Poemtys/ssl-all/前挡板.SLDPRT

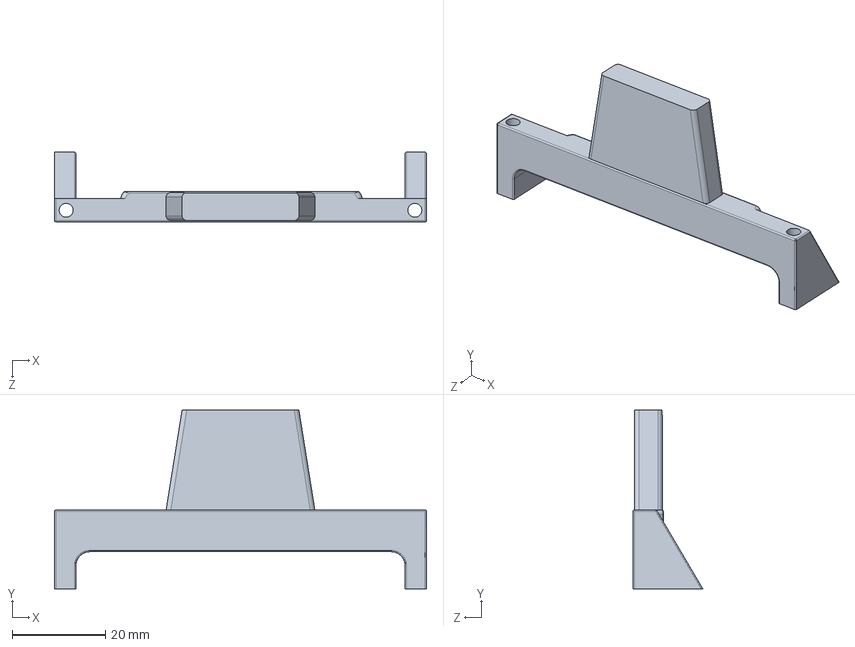
[picture p6: CAD file, 2024-06-06]
前挡板.SLDPRT
80.0 x 38.5 x 15.0 mm
