Poemtys/ssl-all/后挡板.SLDPRT

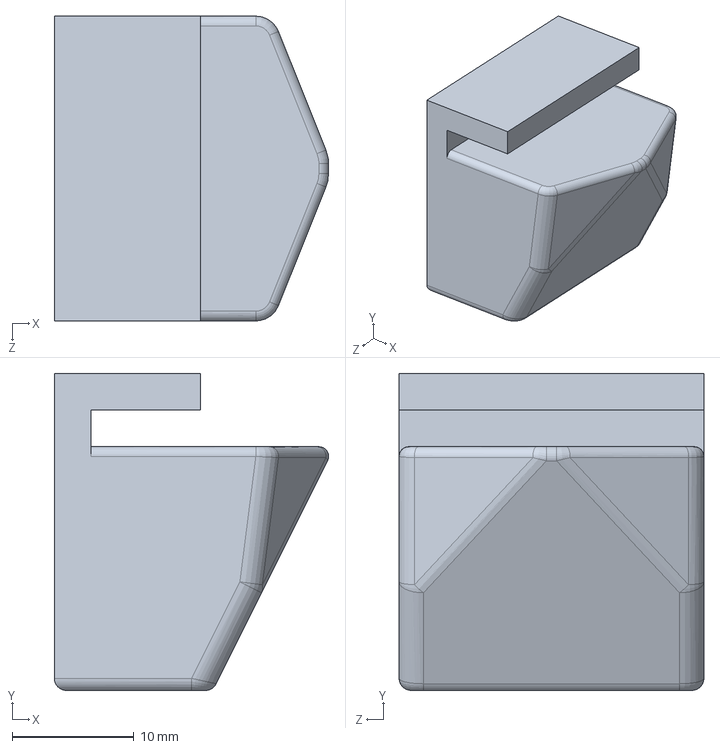
[picture p7: CAD file, 2024-06-06]
后挡板.SLDPRT
22.5 x 26.0 x 25.0 mm
