Poemtys/ssl-all/111.SLDPRT

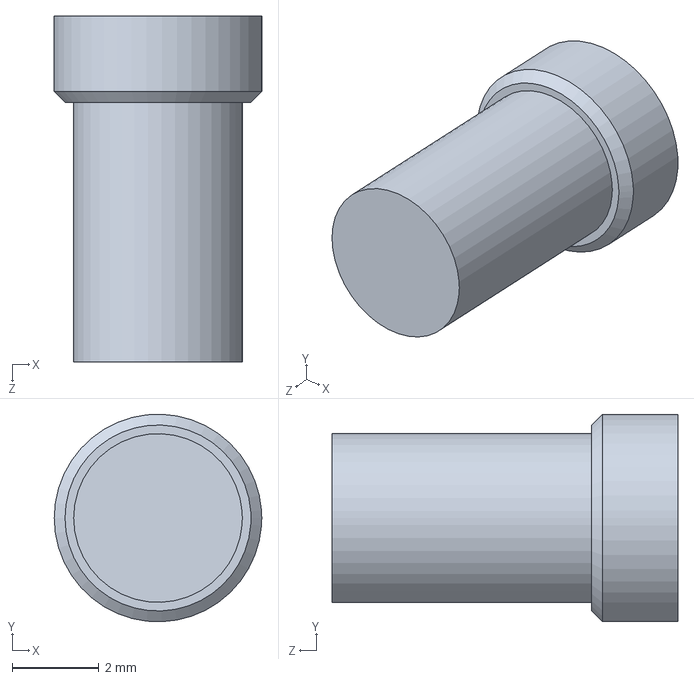
[picture p8: CAD file, 2024-06-06]
111.SLDPRT
4.80 x 4.80 x 8.00 mm
