Poemtys/ssl-all/m0.5motorgear.STEP

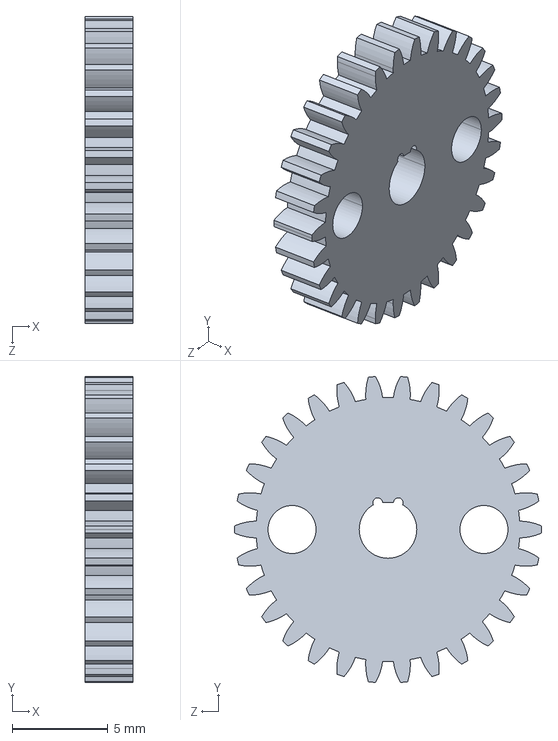
[picture p9: CAD file, 2024-06-06]
m0.5motorgear.STEP
2.50 x 15.9 x 16.0 mm
