Poemtys/ssl-all/零件1.SLDPRT

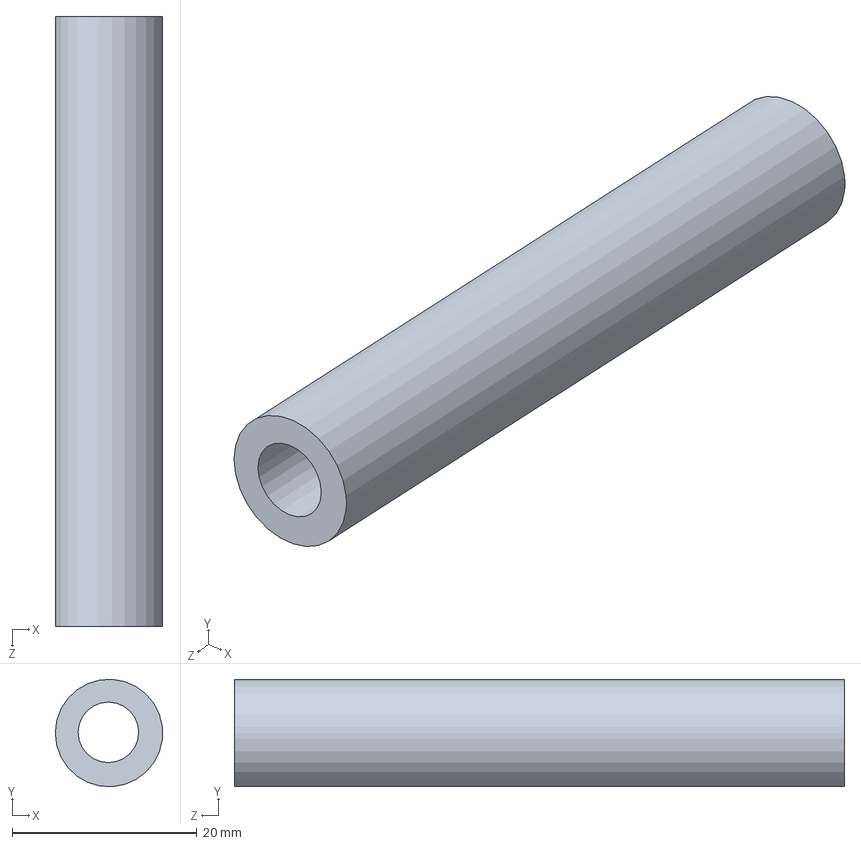
[picture p10: CAD file, 2024-06-06]
零件1.SLDPRT
11.6 x 11.6 x 66.0 mm
