Poemtys/ssl-all/电池盒.SLDPRT

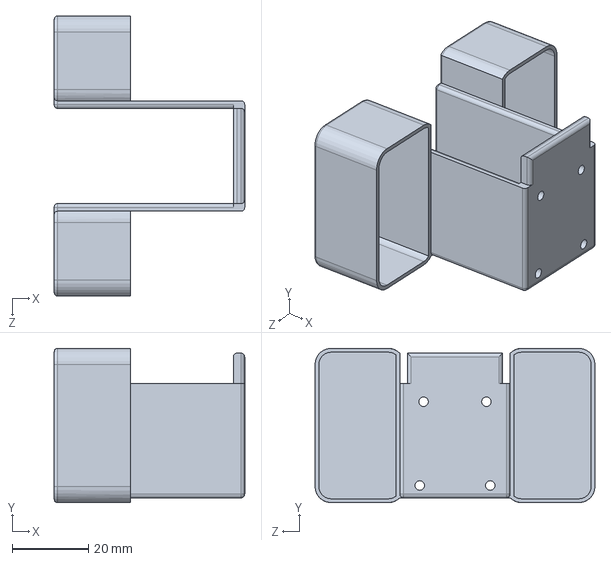
[picture p11: CAD file, 2024-06-06]
电池盒.SLDPRT
50.0 x 40.5 x 73.5 mm
