Poemtys/ssl-all/100832.SLDPRT

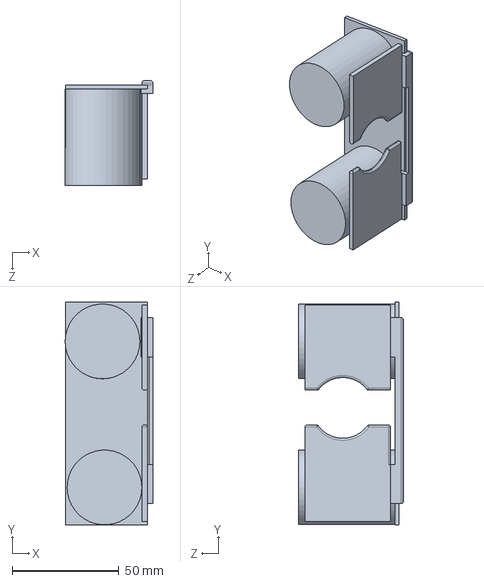
[picture p12: CAD file, 2024-06-06]
100832.SLDPRT
41.1 x 104.4 x 49.0 mm
