Poemtys/ssl-all/(list of files, cad)

Other CAD files:
零件4.SLDDRW
