Poemtys/ssl-all/SSLCtrlBrd_Ver1.3.pdf

PE7 | 38 PE8 | 39 PE9 | 40 PE10 | 41 PE11 | 42 PE12 | 43 PE13 | 44 PE14 | 45 PE15 | 46

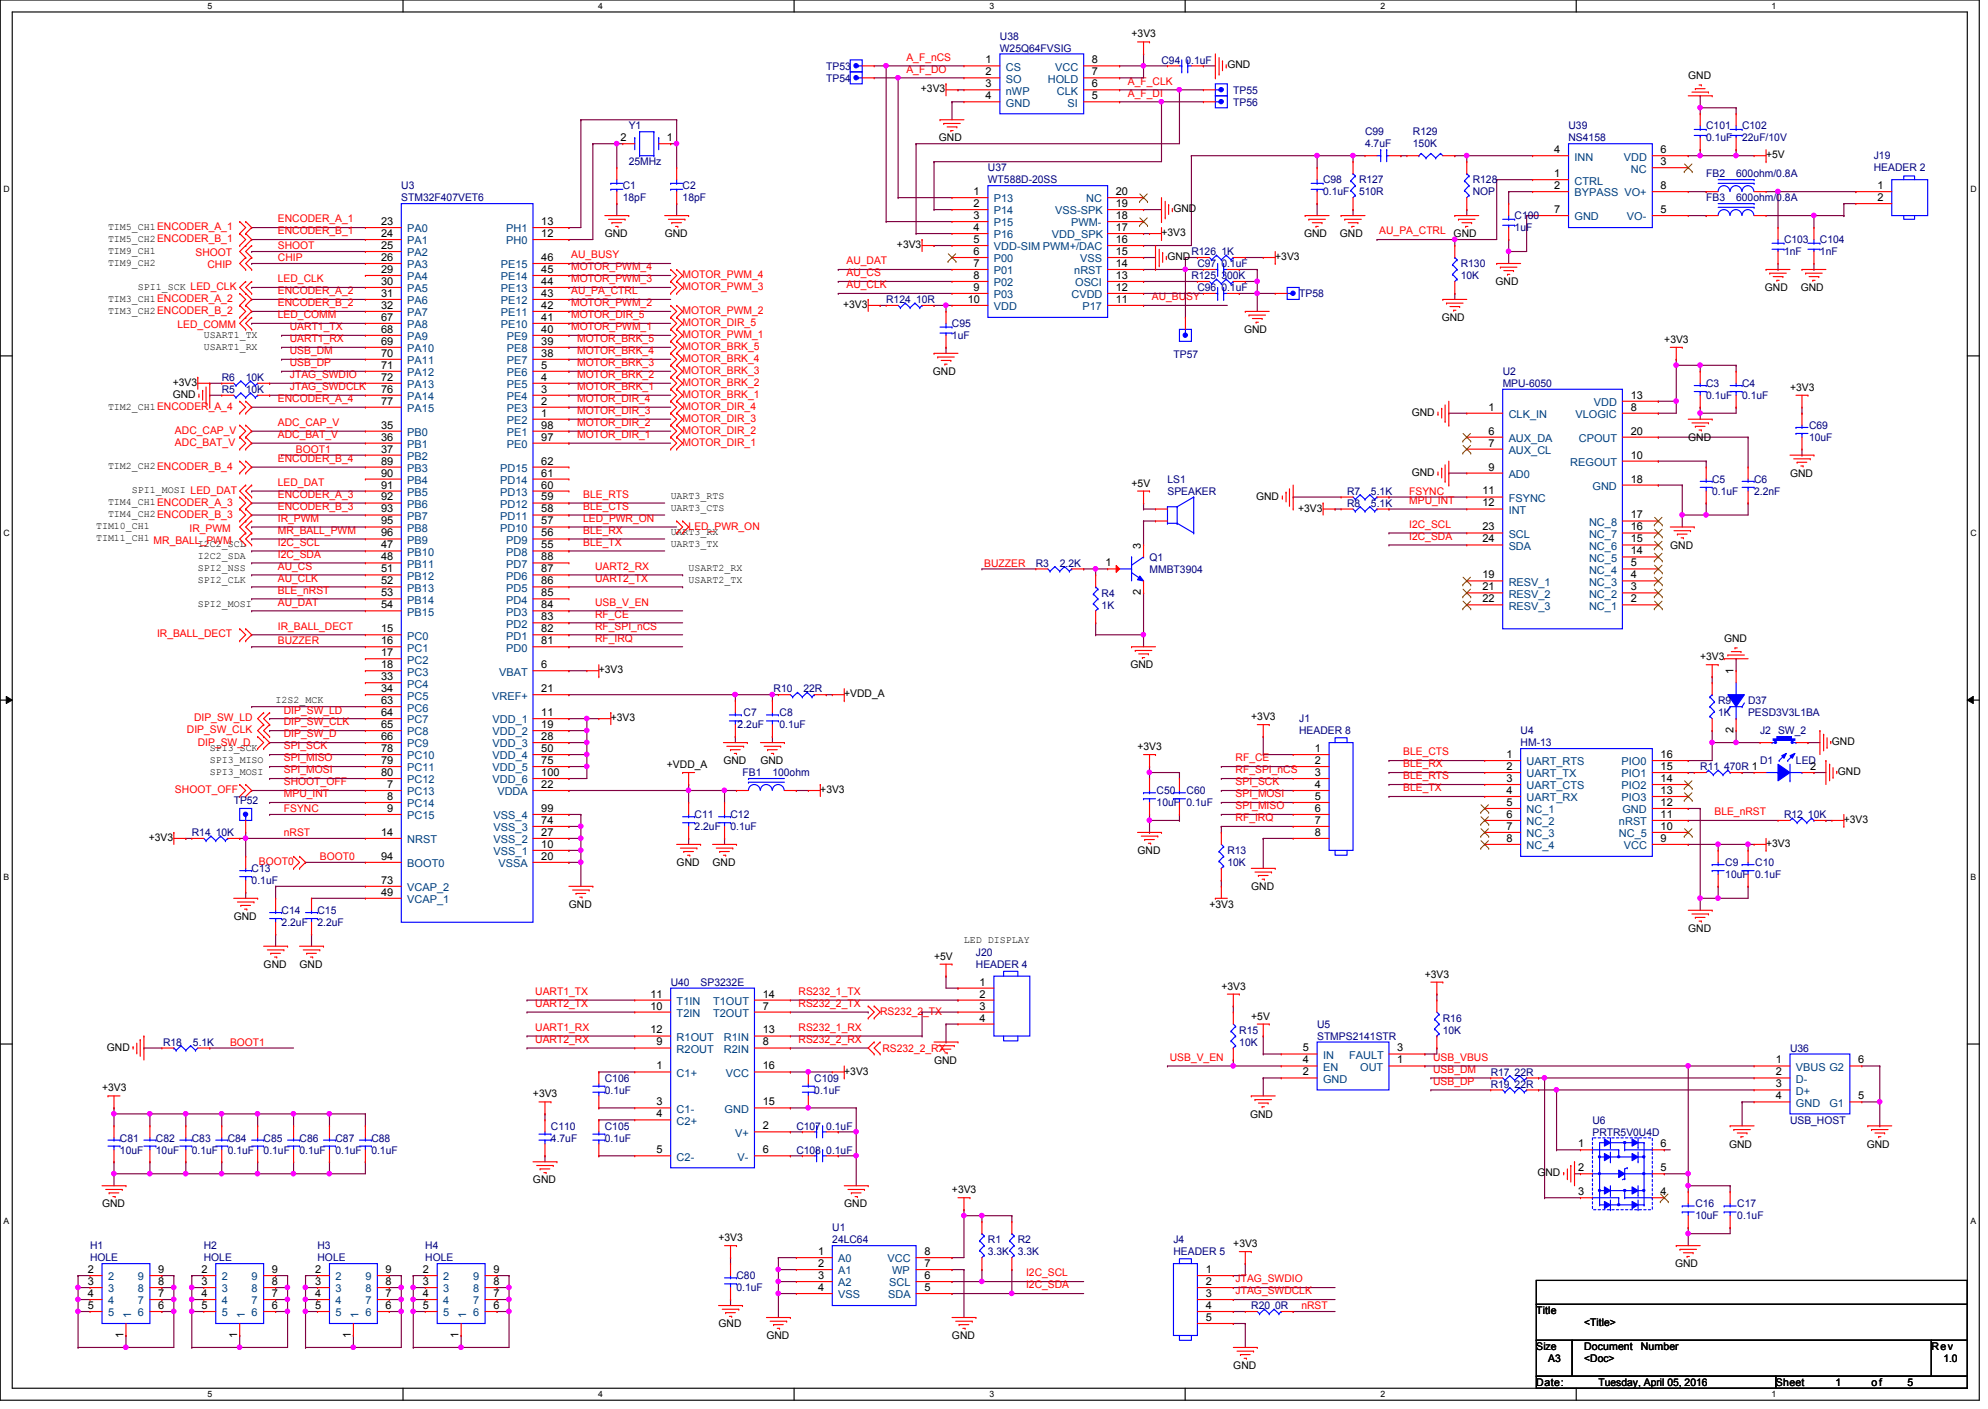
[picture p13: page 1]

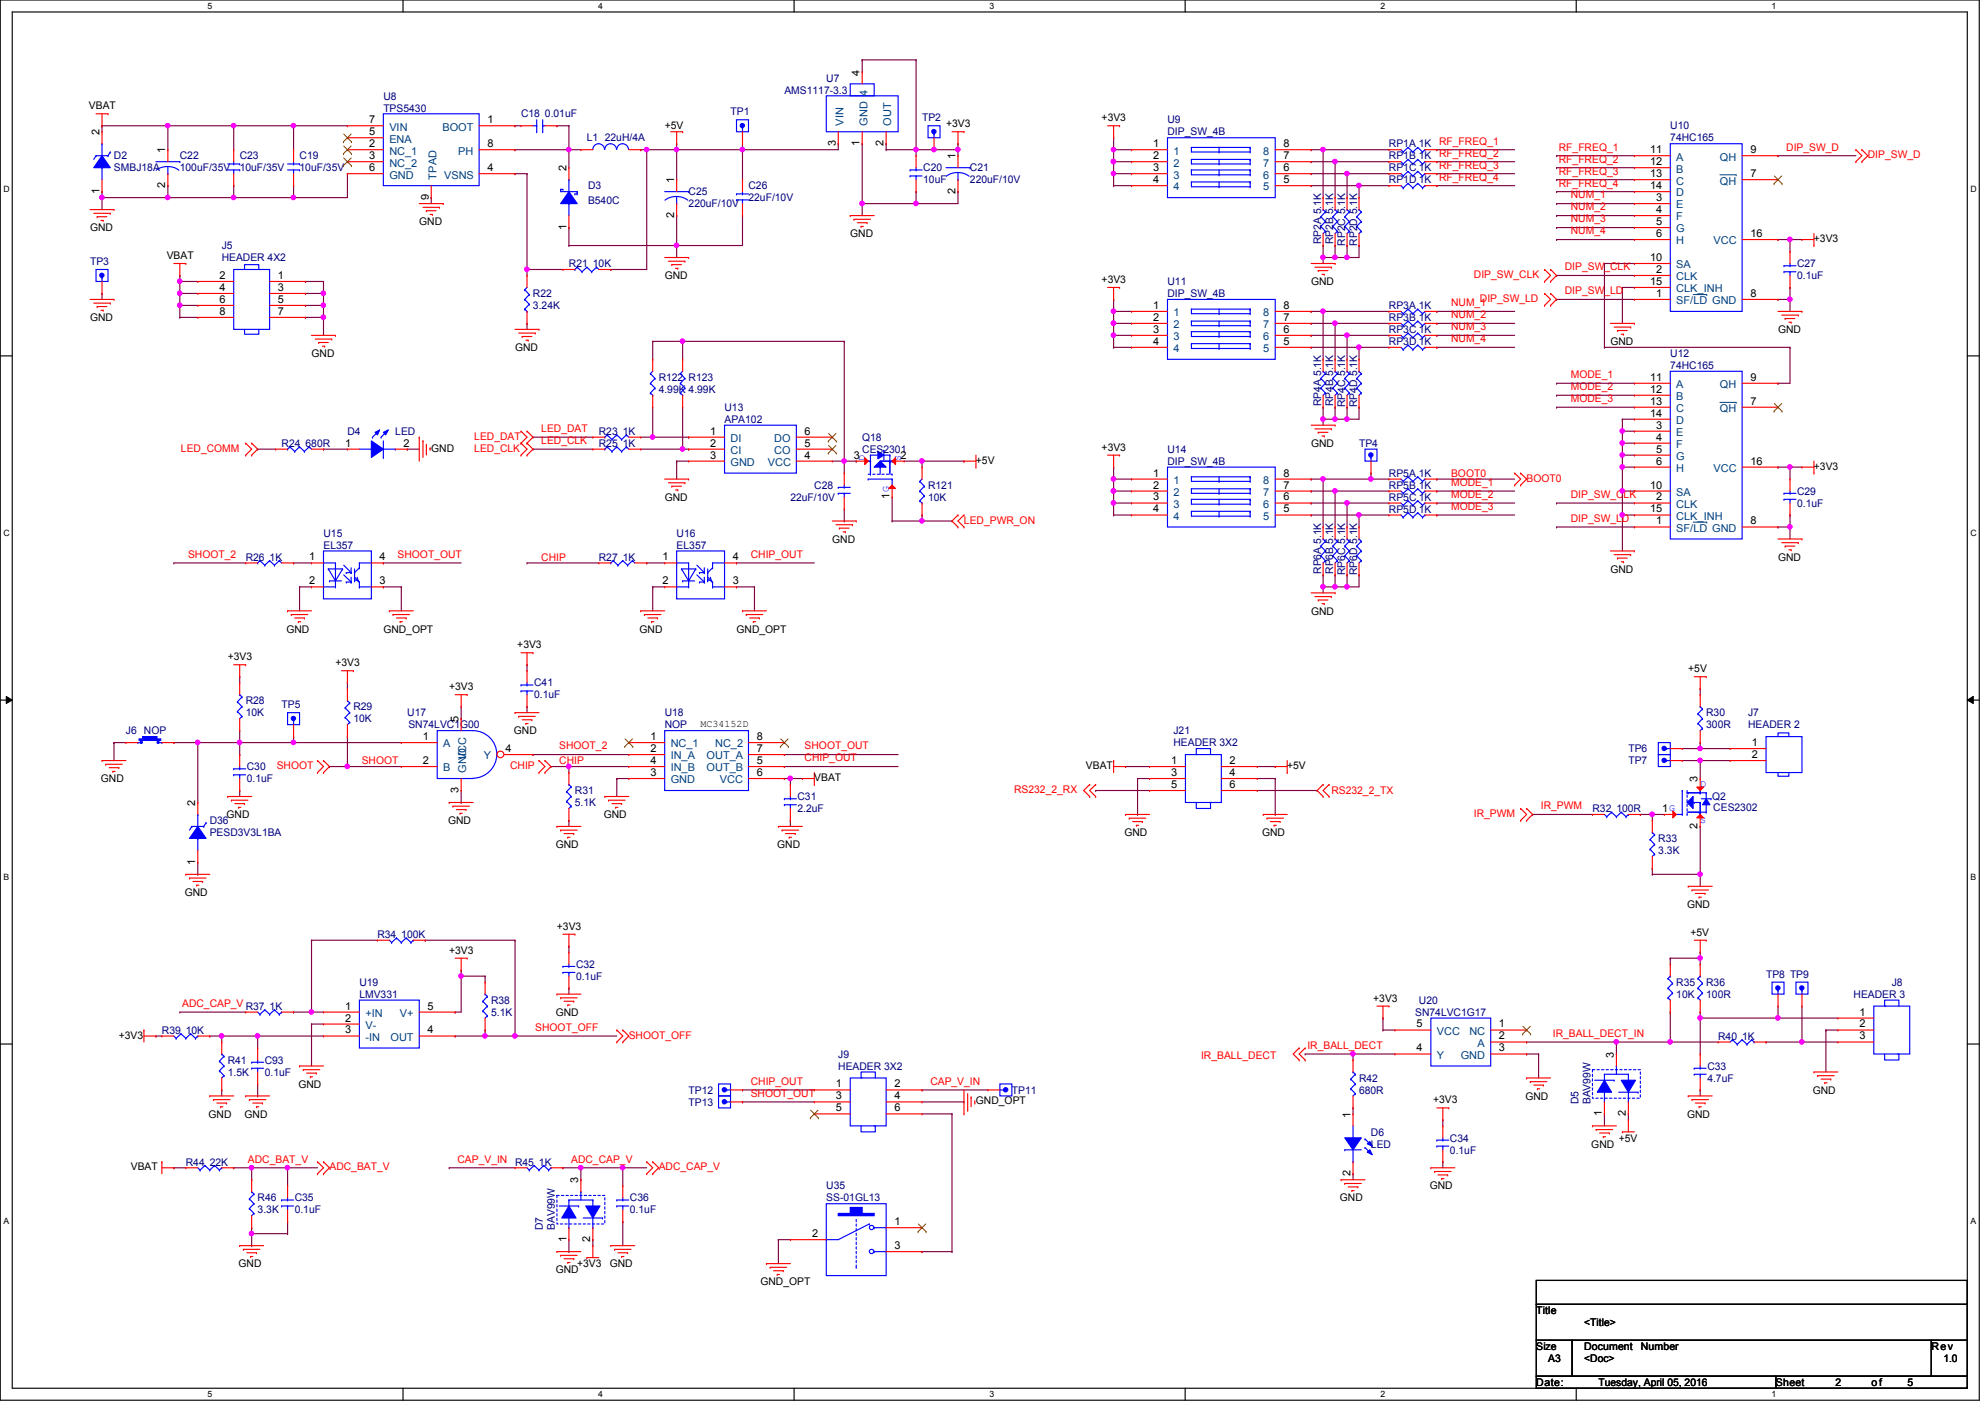
[picture p14: page 2]

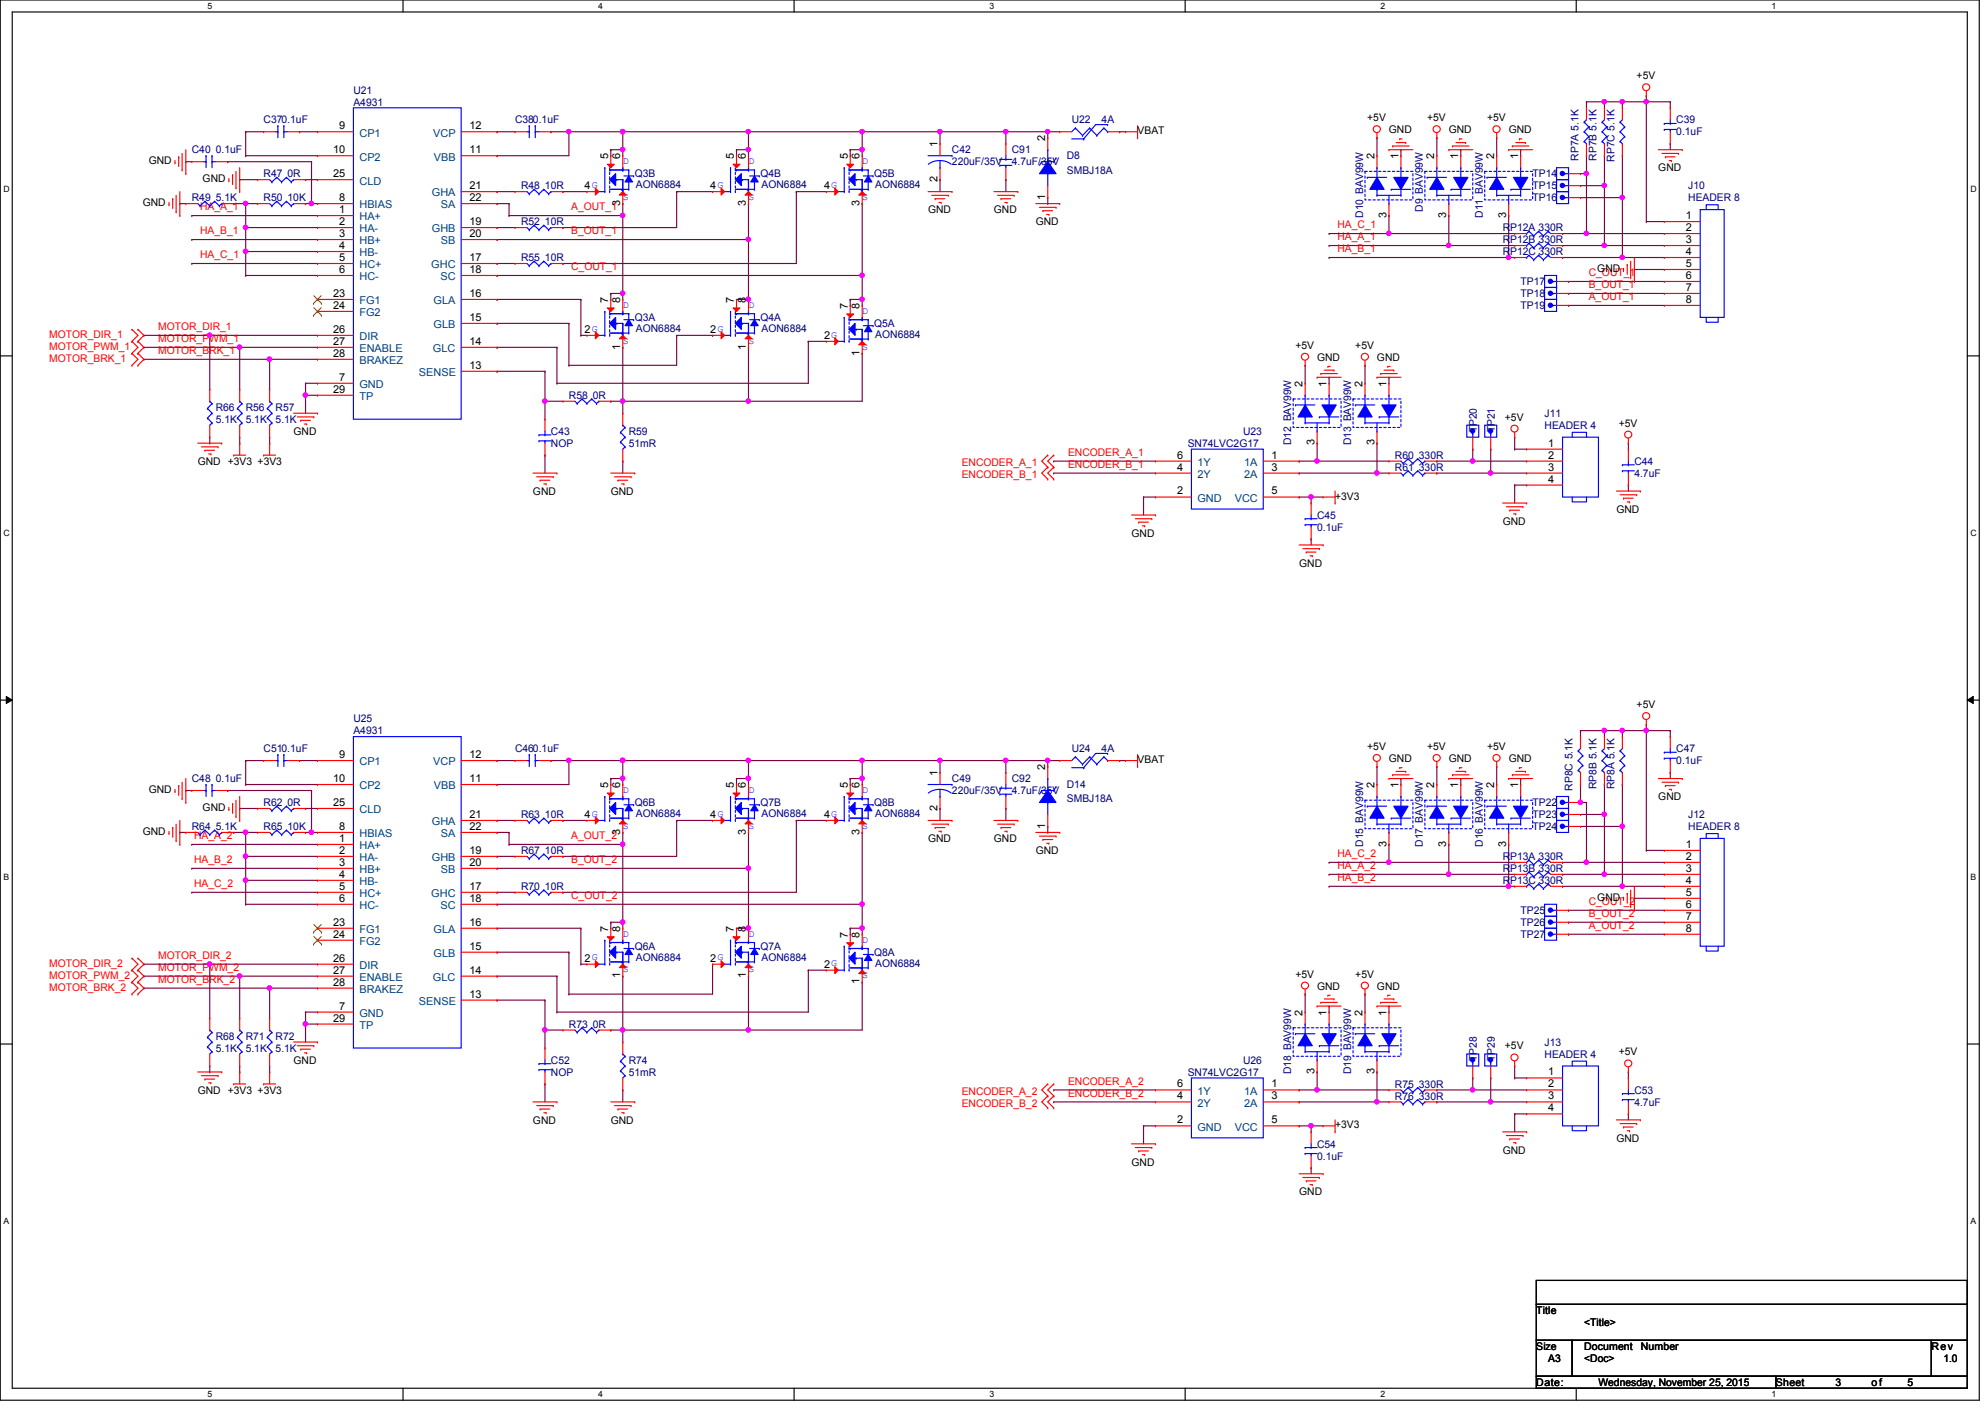
[picture p15: page 3]

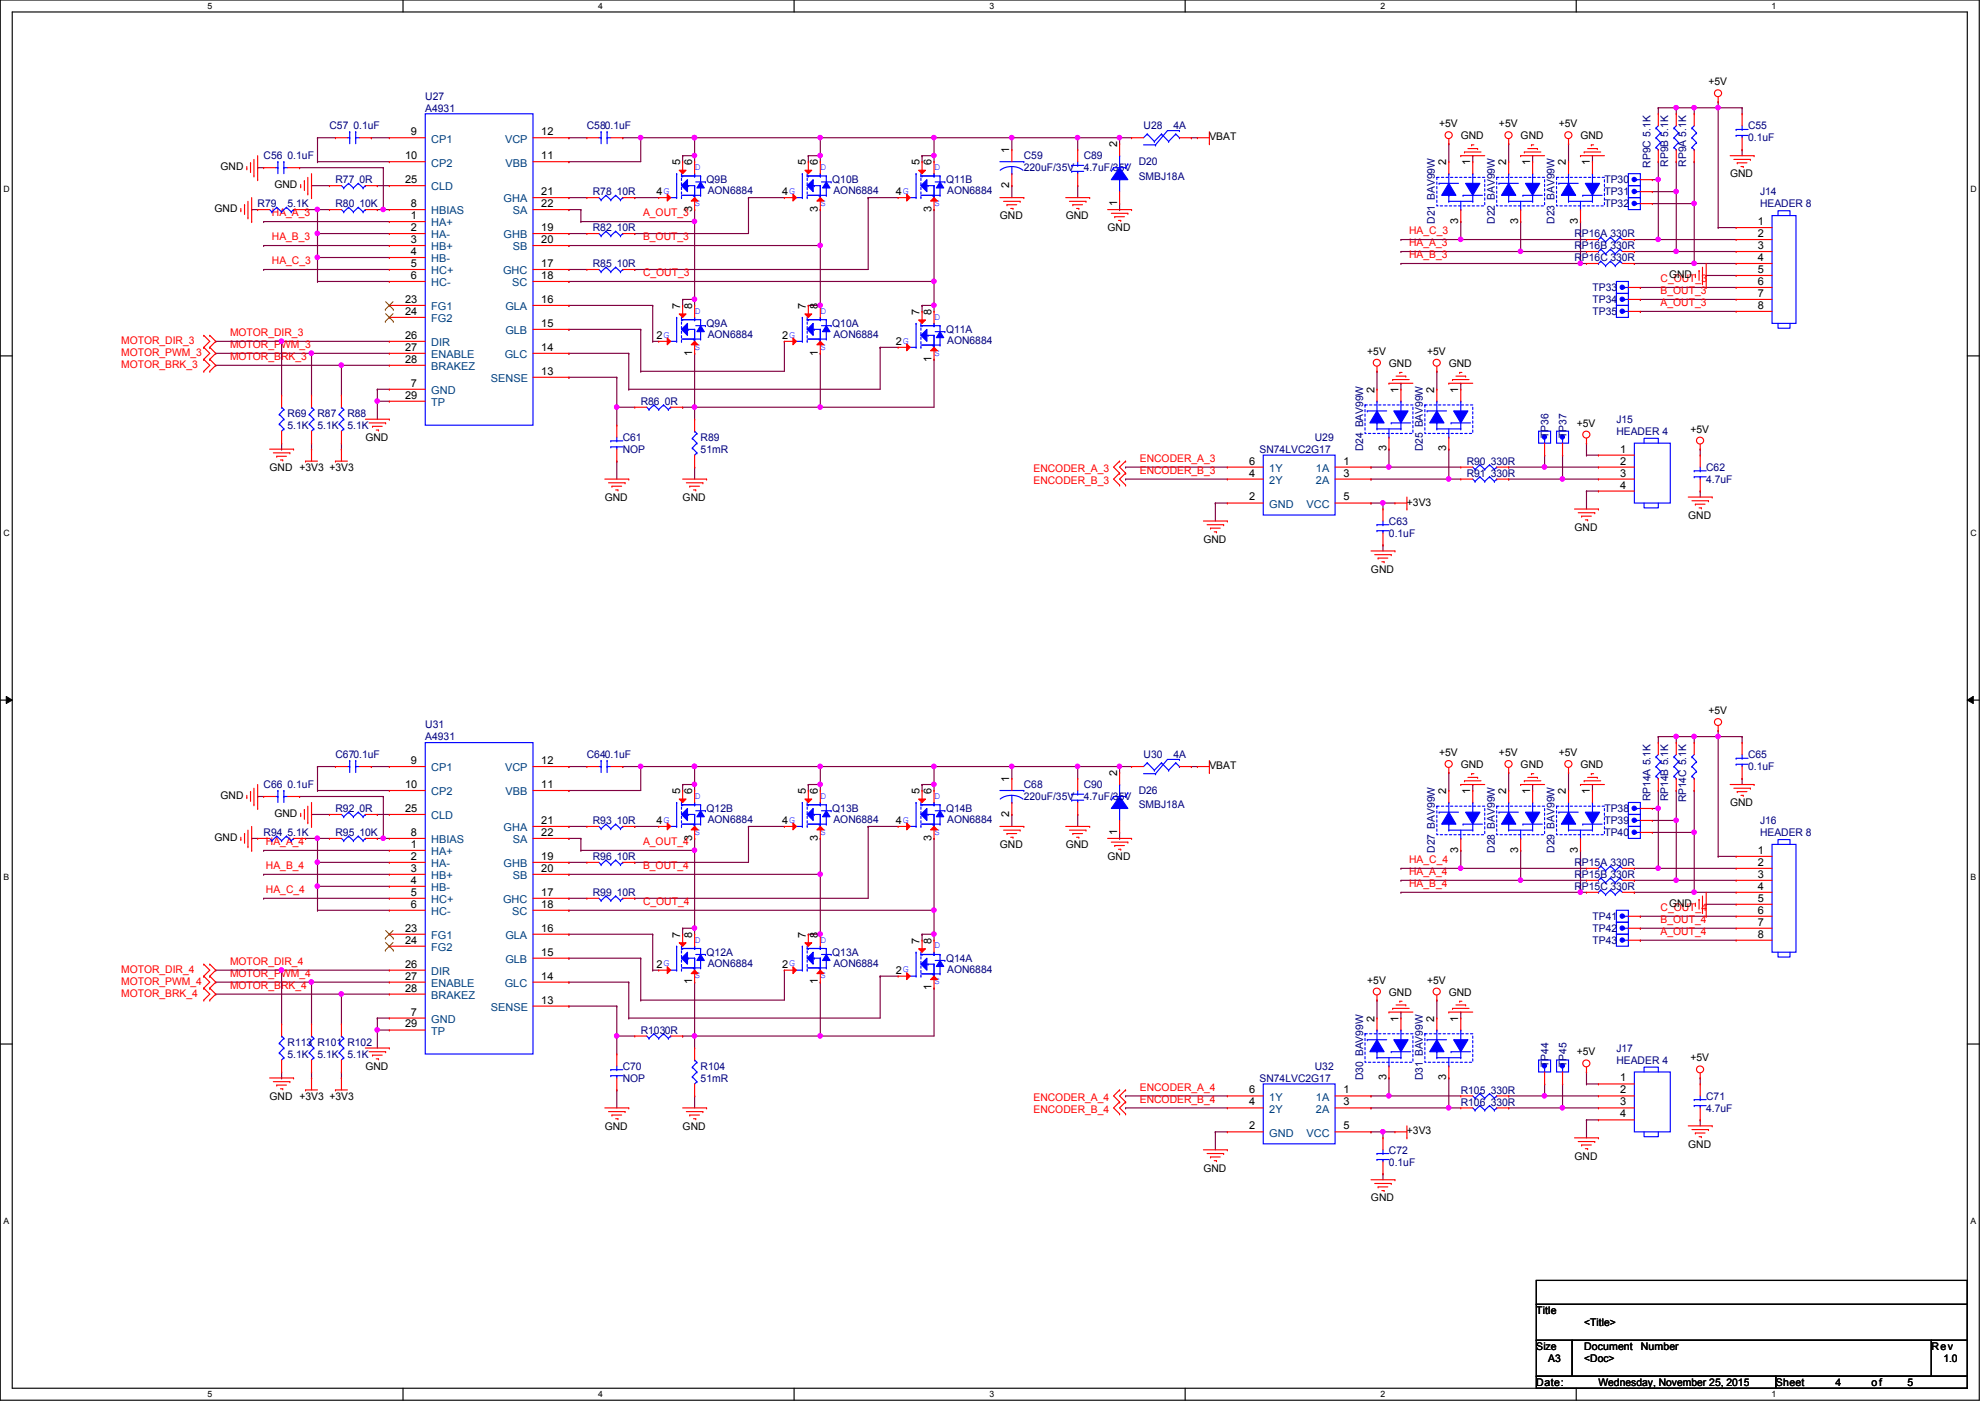
[picture p16: page 4]

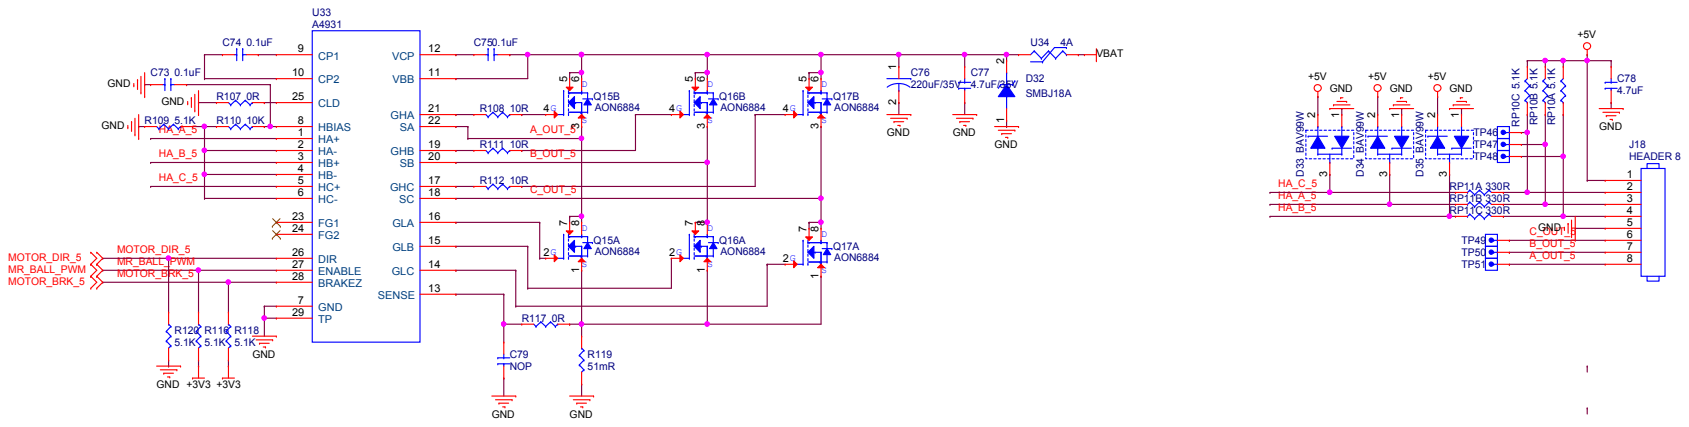
[picture p17: page 5]
