Poemtys/ssl-all/(list of files, drawings)

Other design files:
booster (2019-6-10 17-00)/booster.PcbDoc
booster (2019-6-10 17-00)/booster.PcbLib
booster (2019-6-10 17-00)/booster.PrjPcb
booster (2019-6-10 17-00)/booster.SchDoc
booster (2019-6-10 17-00)/booster.SCHLIB
原理图/Sheet1.SchDoc
原理图/Sheet2.SchDoc
原理图/Sheet3.SchDoc
原理图/Sheet4.SchDoc
原理图/Sheet5.SchDoc
